snikolaj/RT-Thread_IoT_Contest/Client/Client Breadboard with Debug.jpg

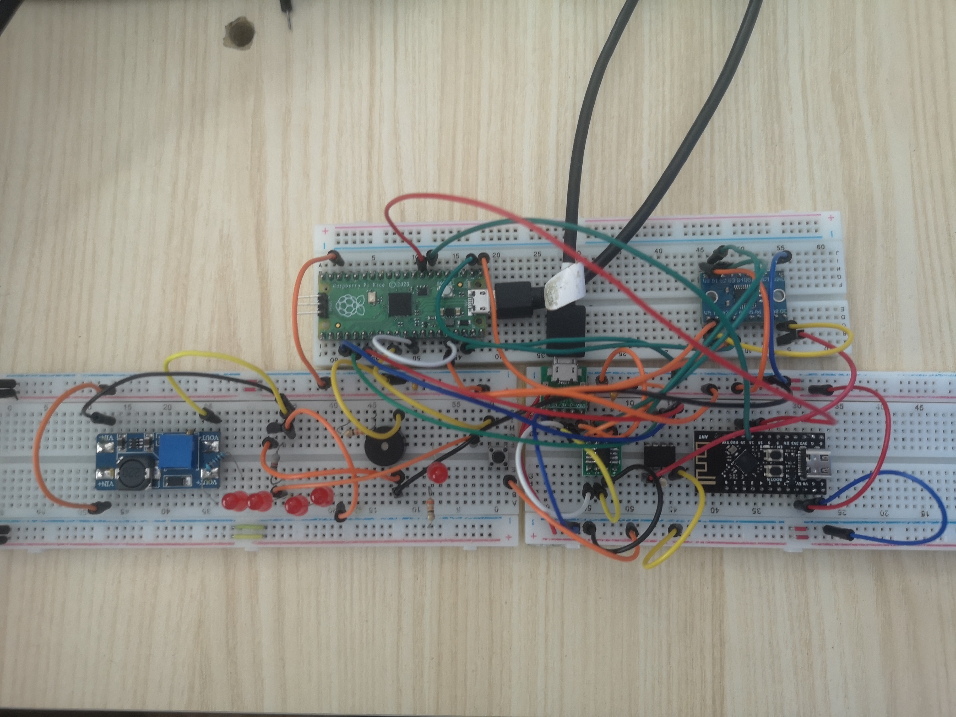
Client/Client Breadboard with Debug.jpg
