snikolaj/RT-Thread_IoT_Contest/README.md

# RT-Thread_IoT_Contest

A repository for my submission for the RT-Thread IoT Contest.
