snikolaj/RT-Thread_IoT_Contest/Bill of Materials.csv

ID | Name | Designator | Footprint | Quantity | Manufacturer Part | Manufacturer | Supplier | Supplier Part | Price
1 | 4.7u | C1,C6,C7 | CAP-D5.0×F2.0 | 3
2 | 10u | C2,C3,C9 | CAP-D5.0×F2.0 | 3
3 | 100n | C4,C10 | RAD-0.1 | 2
4 | 2.2n | C5,C8 | RAD-0.1 | 2
5 | 1N4148 | D1 | DO-35_BD2.0-L4.2-P8.20-D0.5-RD | 1 | 1N4148 | STMicroelectronics | LCSC | C13769
6 | LED-TH-5mm_R | LED1 | LED-TH_BD5.0_RED | 1 | 333-2SURD/S530-A3 | EVERLIGHT(台湾亿光) | LCSC | C87271 | 0.032
7 | LED-TH-5mm_B | LED2 | LED-TH_BD5.0_BLUE | 1 |  |  | LCSC
8 | HB100 | M1 | HB100 MICROWAVE SENSOR MODULE | 1 | HB100
9 | RTC 1302 | M2 | DS1302_RTC | 1 | F185-1210A0BA1
10 | 2N3904(TO-92) | Q1 | TO-92-3_L5.1-W4.1-P1.27-L | 1 | 2N3904 | SEMTECH | LCSC | C118538 | 0.016
11 | 12k | R1 | R_AXIAL-0.3 | 1
12 | 10k | R2,R3,R6,R9 | R_AXIAL-0.3 | 4
13 | 330k | R4 | R_AXIAL-0.3 | 1
14 | 1M | R5,R8 | R_AXIAL-0.3 | 2
15 | 82k | R7 | R_AXIAL-0.3 | 1
16 | 1k | R10,R12,R13 | R_AXIAL-0.3 | 3
17 | 12 | R11 | R_AXIAL-0.3 | 1
18 | CH340N | U3 | SOP-8_L5.0-W4.0-P1.27-LS6.0-BL | 1 | CH340N | WCH(南京沁恒) | LCSC | C506813 | 0.528
19 | Raspberry Pi Pico | U4,U5 | PICO | 2 |  | Raspberry Pi Foundation |  | Pico
20 | ESP32-C3-DevKitM-1 | U6,U9 | ESP32-C3-DEVKITM-1 | 2
21 | MT3608_3 | U7 | MT3608_1 | 1
22 | Buzzer | U8 | BUZ-TH_BD22.0-P10.00_BUZZER_PIEZO_HX-2212 | 1 | HX-2212 | null | LCSC | C9900023877
23 | USB DEBUG PORT | USB1 | MINI-USB-SMD_C105424 | 1 | USB-MINI-SMD-9.2X9.4-H3.7 | LCSC | LCSC | C105424 | 0.097
24 | LM358N | U1,U2 | PDIP-8_L9.3-W6.4-P2.54-LS7.9-BL-1 | 2 | LM358N | XICOR | LCSC | C4366086 | 0.353
