snikolaj/RT-Thread_IoT_Contest/UV-C Project Schematic.pdf

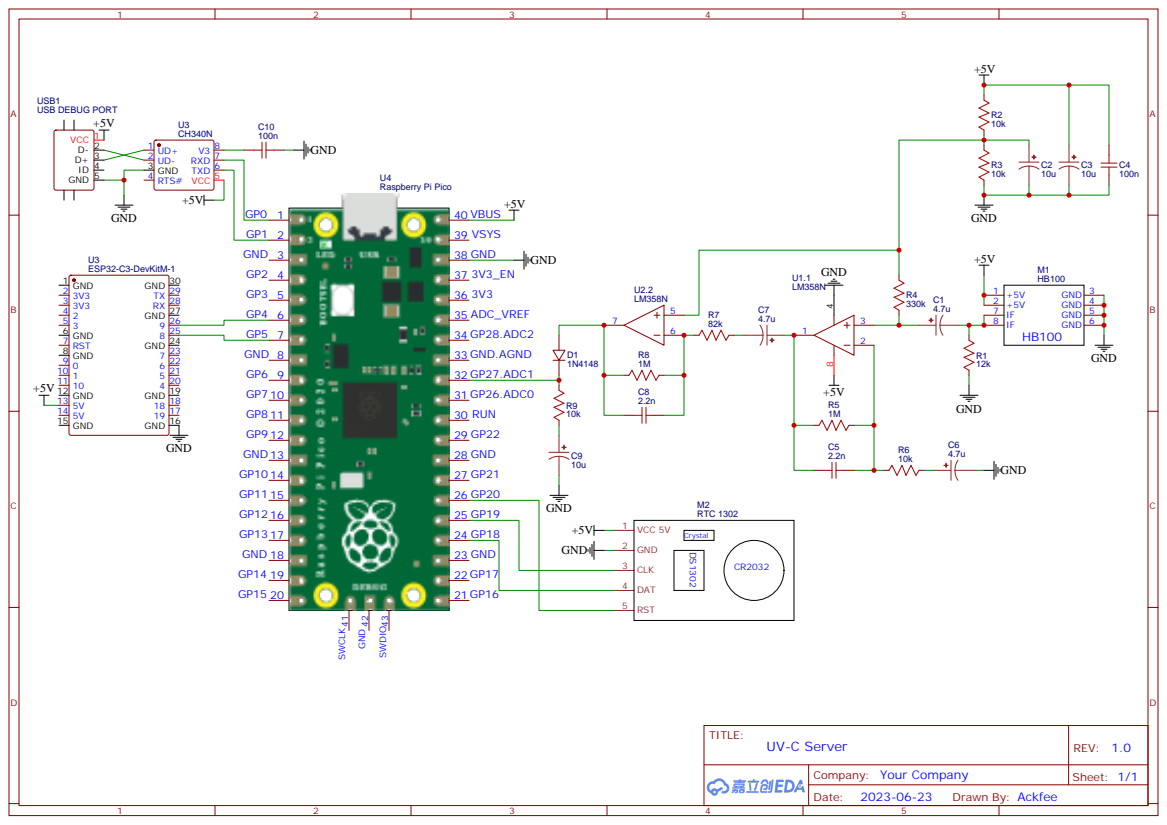
[picture p5: page 1]

26 GND 27 RX 28 TX 29 GND 30

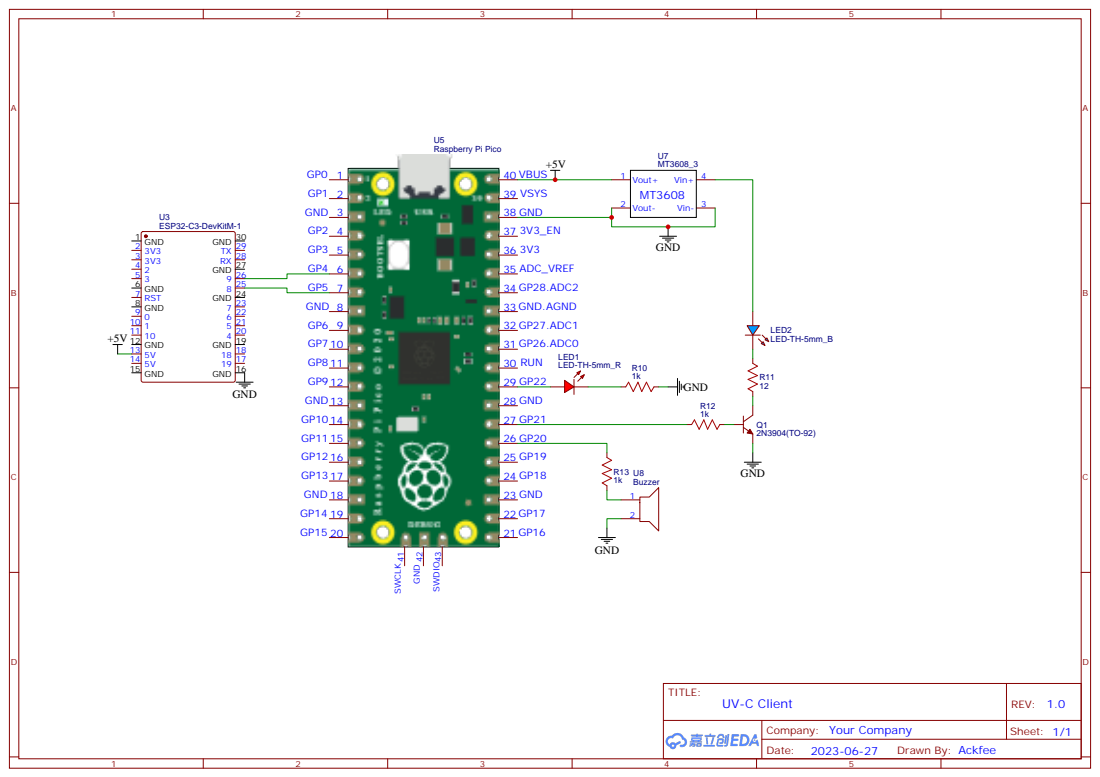
[picture p6: page 2]

26 GND 27 RX 28 TX 29 GND 30
